mattsoftware/toads_breakout/ToadsBreakout-v1.1/ToadsBreakout-v1.1.pdf

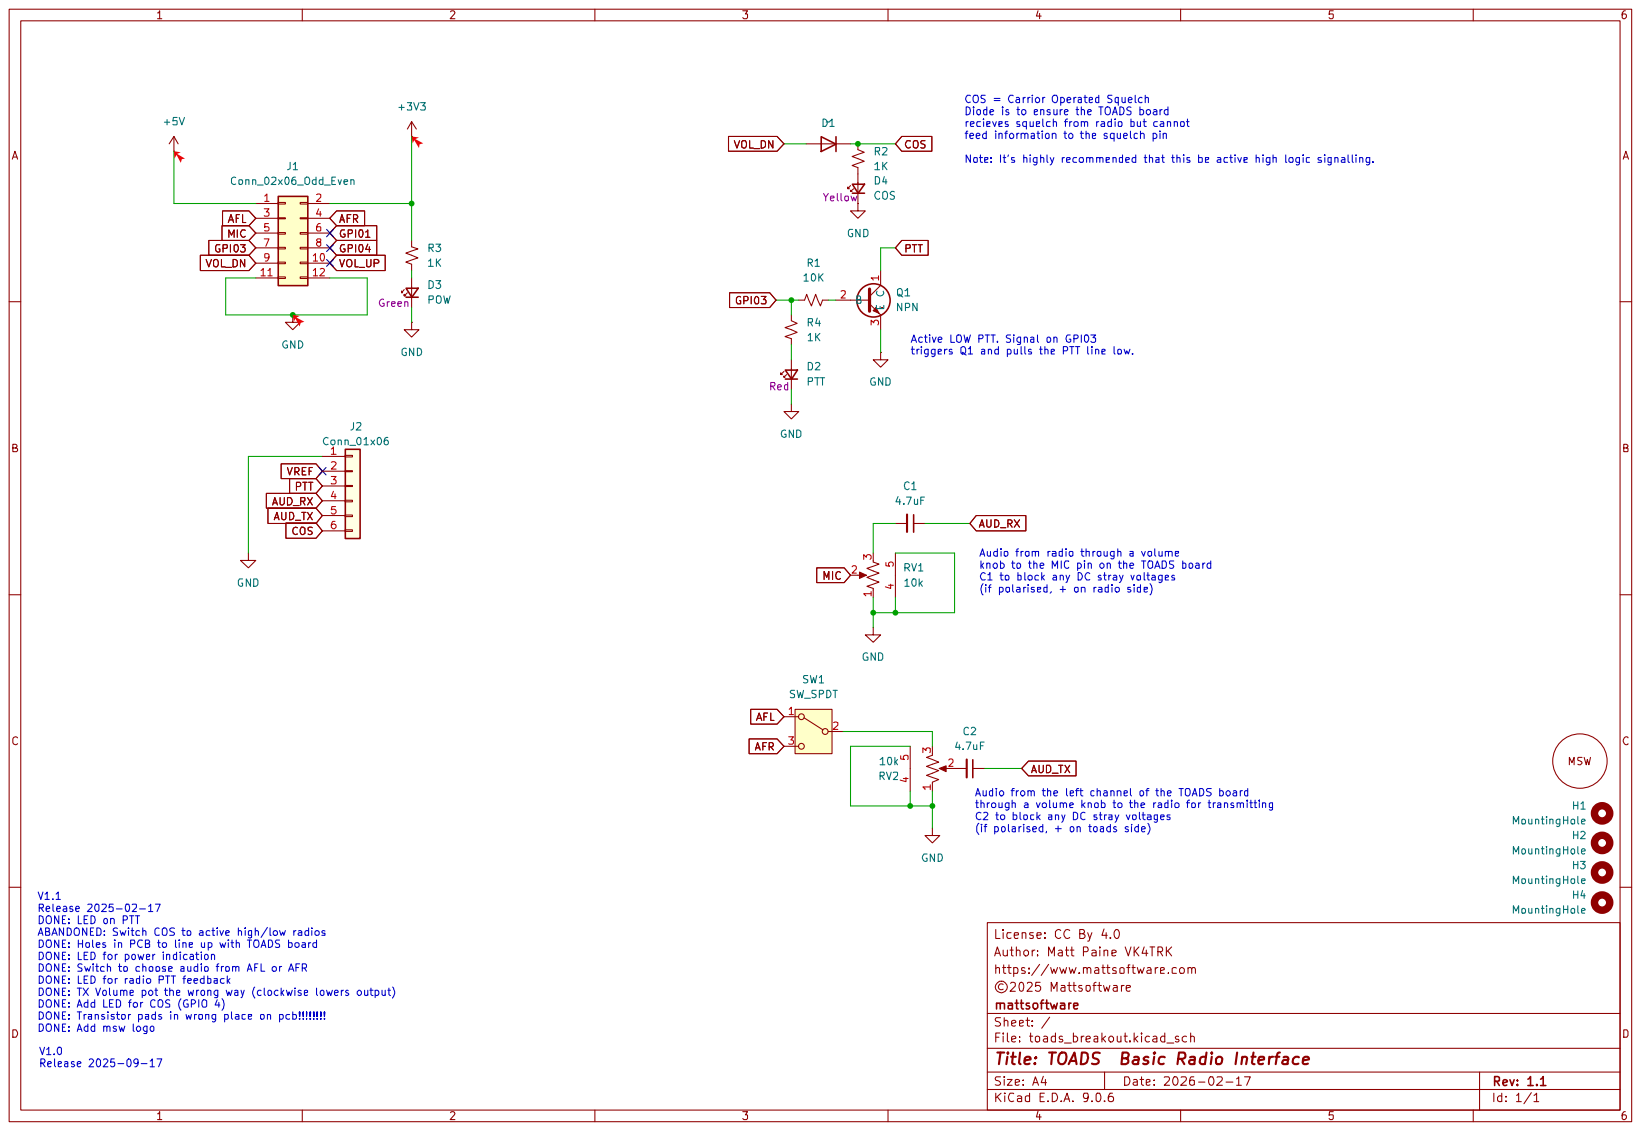
[picture p1: page 1]
