mattsoftware/toads_breakout/ToadsBreakout-v1.0/ToadsBreakout-v1.0.pdf

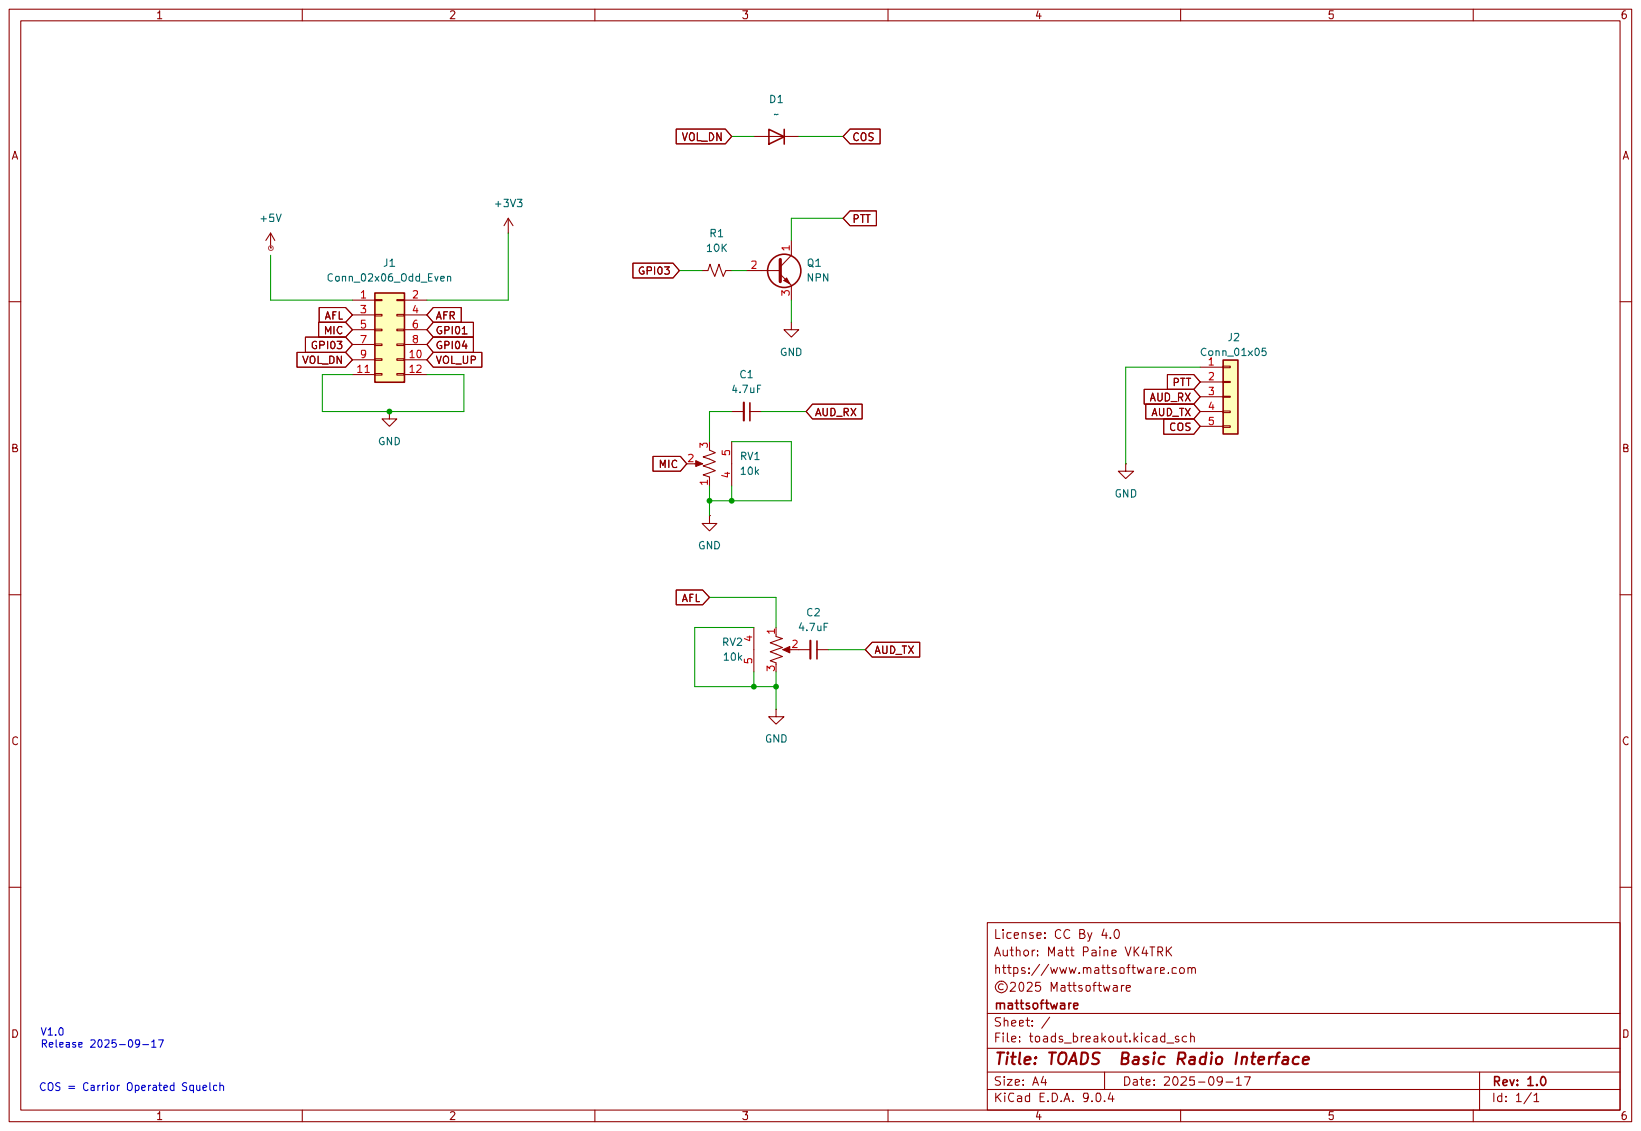
[picture p2: page 1]
