mattsoftware/toads_breakout/toads_breakout.kicad_pcb

## KiCad design toads_breakout.kicad_pcb (2026-02-17)

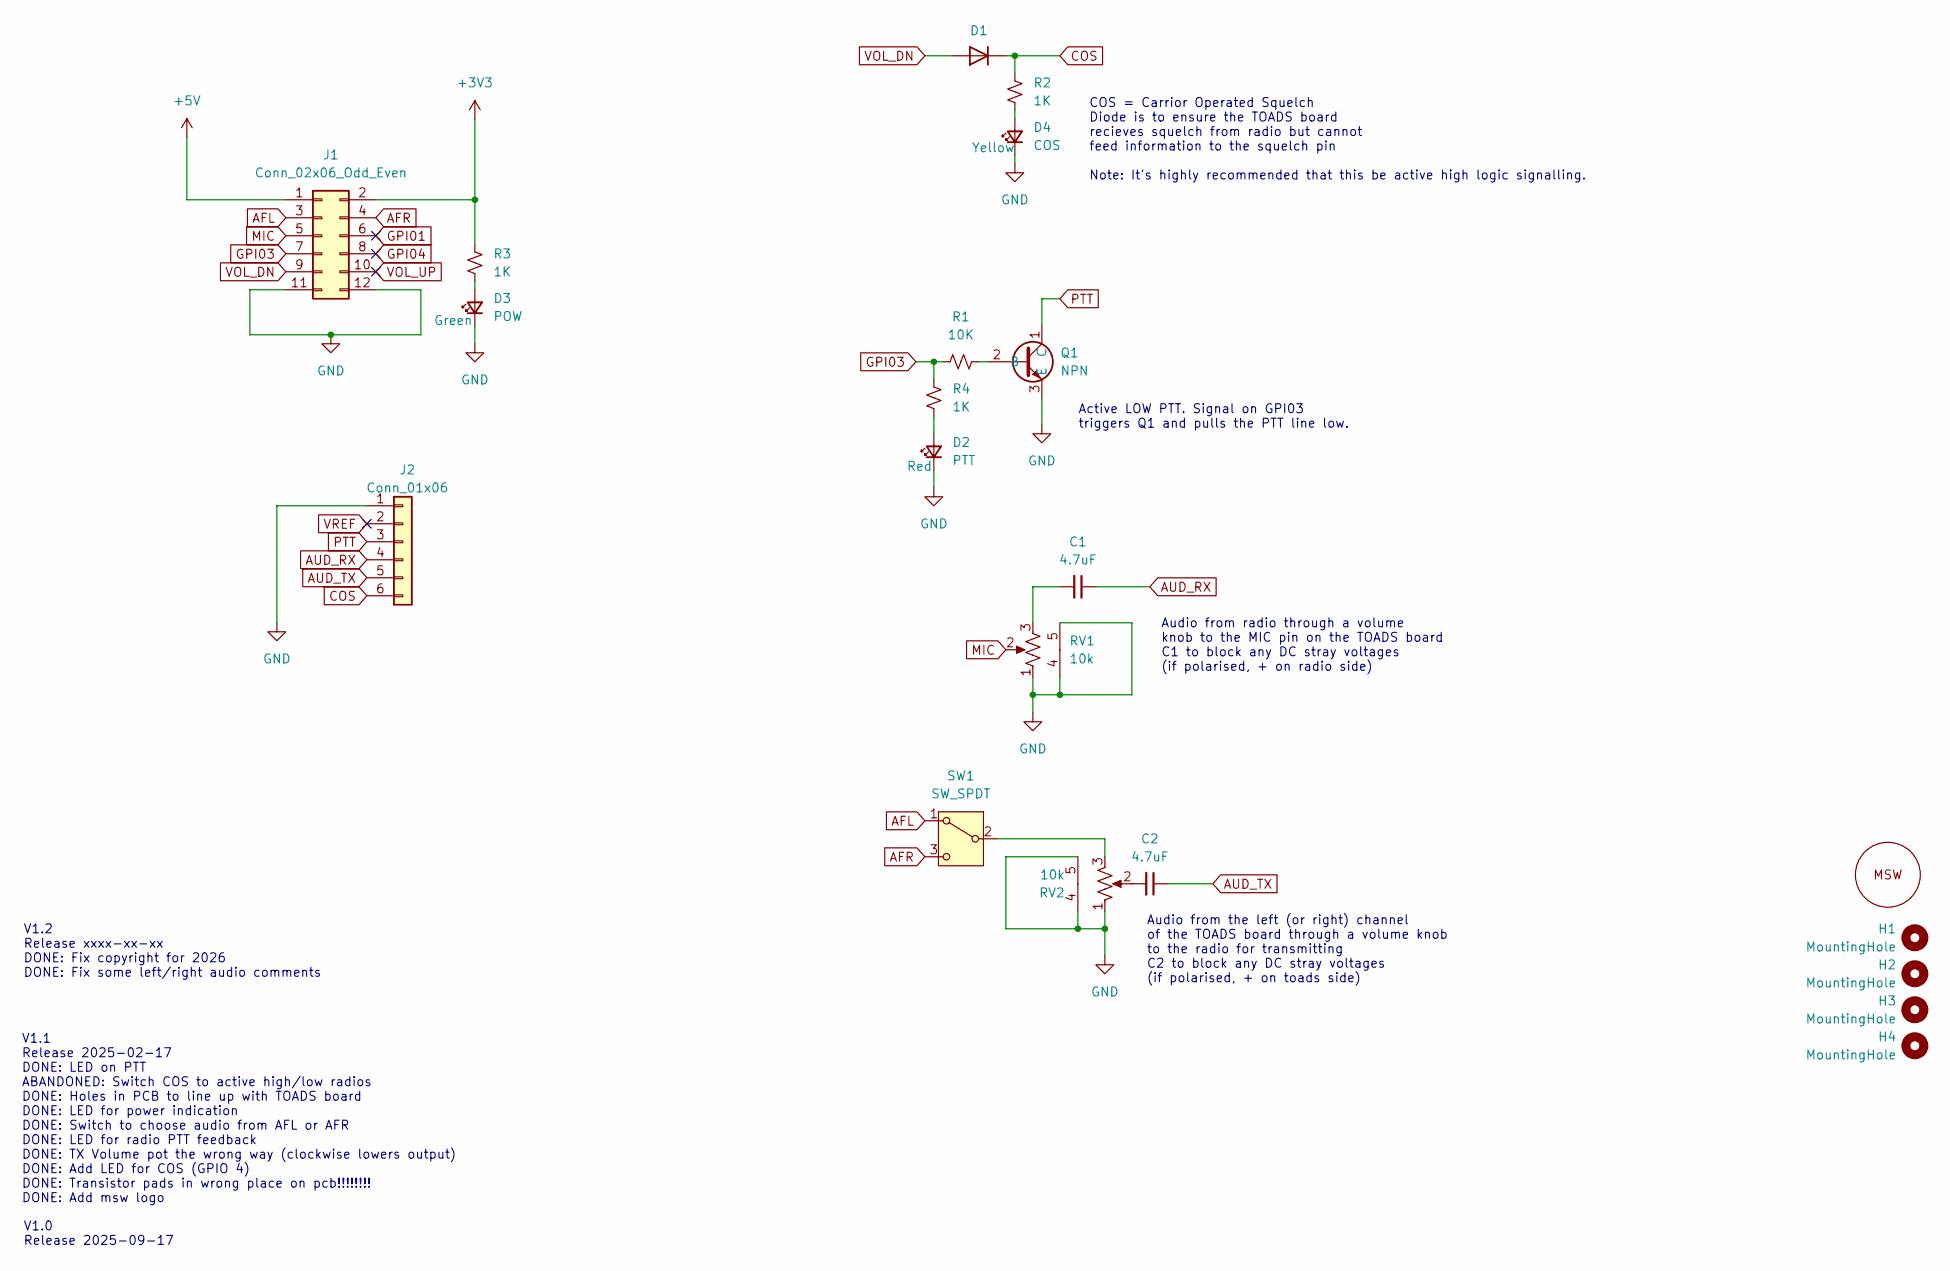
[picture p3: schematic toads_breakout.kicad_sch, TOADS Basic Radio Interface]

Parts:
C1, C2: 4.7uF; C_0805_2012Metric_Pad1.18x1.45mm_HandSolder; LCSC# C1779
D1: D_SOD-123FL; LCSC# C64898
D2: PTT; LED_0805_2012Metric; LCSC# C84256
D3: POW; LED_0805_2012Metric; LCSC# C2297
D4: COS; LED_0805_2012Metric; LCSC# C2296
H1, H2, H3, H4: MountingHole; MountingHole_2.5mm_Pad
J1: Conn_02x06_Odd_Even; PinHeader_2x06_P2.54mm_Vertical; LCSC# C124388
J2: Conn_01x06; PinHeader_1x06_P2.54mm_Vertical; LCSC# C37208
Q1: NPN; SOT-23_Handsoldering; LCSC# C2145
R1: 10K; R_0805_2012Metric_Pad1.20x1.40mm_HandSolder; LCSC# C17414
R2, R3, R4: 1K; R_0805_2012Metric_Pad1.20x1.40mm_HandSolder; LCSC# C17513
RV1, RV2: 10k; R_Potentiometer-10k-C361173; LCSC# C361173
SW1: SW_SPDT; SW-SPDT-C49023767; LCSC# C49023767
U1: MSW_Logo; MSW

Connections:
+3V3: J1.2, R3.1
+5V: J1.1
AFL: J1.3, SW1.1 (A)
AFR: J1.4, SW1.3 (C)
AUD_RX: C1.1, J2.4
AUD_TX: C2.1, J2.5
COS: D1.1 (K), J2.6, R2.1
GND: D2.1 (K), D3.1 (K), D4.1 (K), J1.11, J1.12, J2.1, Q1.3 (E), RV1.1, RV1.4, RV1.5, RV2.1, RV2.4, RV2.5
GPI01: J1.6
GPI03: J1.7, R1.1, R4.1
GPI04: J1.8
MIC: J1.5, RV1.2
unnamed: C1.2, RV1.3
unnamed: C2.2, RV2.2
unnamed: D2.2 (A), R4.2
unnamed: D3.2 (A), R3.2
unnamed: D4.2 (A), R2.2
unnamed: Q1.2 (B), R1.2
unnamed: RV2.3, SW1.2 (B)
PTT: J2.3, Q1.1 (C)
VOL_DN: D1.2 (A), J1.9
VOL_UP: J1.10
VREF: J2.2

Notes on the sheet:
Audio from radio through a volume knob to the MIC pin on the TOADS board C1 to block any DC stray voltages (if polarised, + on radio side)
Audio from the left (or right) channel of the TOADS board through a volume knob to the radio for transmitting C2 to block any DC stray voltages (if polarised, + on toads side)
COS = Carrior Operated Squelch Diode is to ensure the TOADS board recieves squelch from radio but cannot feed information to the squelch pin Note: It's highly recommended that this be active high logic signalling.
V1.1 Release 2025-02-17 DONE: LED on PTT ABANDONED: Switch COS to active high/low radios DONE: Holes in PCB to line up with TOADS board DONE: LED for power indication DONE: Switch to choose audio from AFL or AFR DONE: LED for radio PTT feedback DONE: TX Volume pot the wrong way (clockwise lowers ou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
V1.0 Release 2025-09-17
V1.2 Release xxxx-xx-xx DONE: Fix copyright for 2026 DONE: Fix some left/right audio comments
Active LOW PTT. Signal on GPI03 triggers Q1 and pulls the PTT line low.

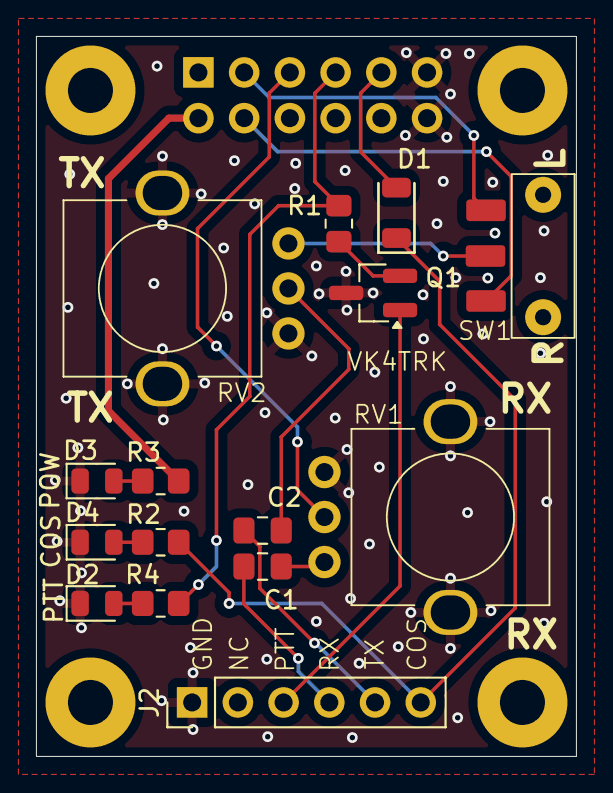
[picture p4: board toads_breakout.kicad_pcb from above]

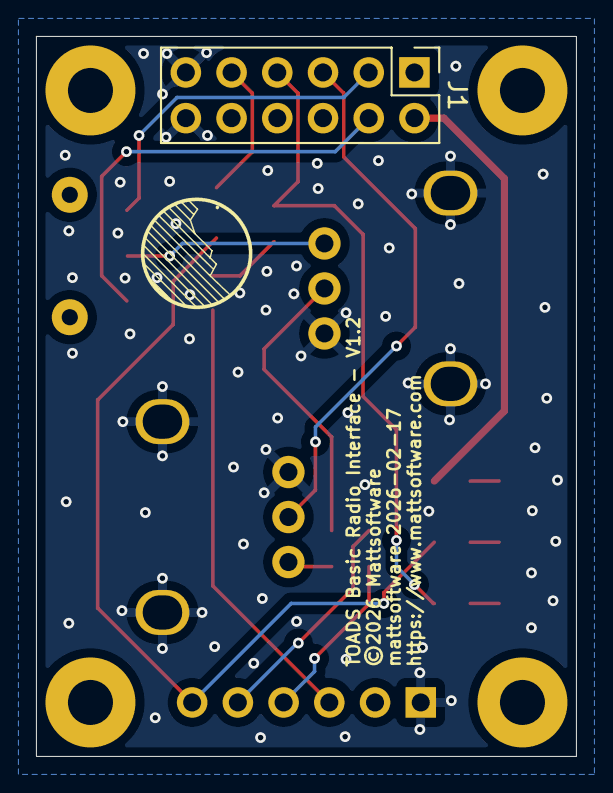
[picture p5: board toads_breakout.kicad_pcb from below]

Board: 2 copper layers, 30.0 x 40.0 mm, 21 parts (2 on the bottom side), 18 nets.
