mattsoftware/toads_breakout/(notices)

Notices in the files:
toads_breakout.kicad_pcb:
©2026 Mattsoftware
License: CC By 4.0
https://creativecommons.org/licenses/by/4.0
